arthursgonzaga/LineFollowerFPGA/Gerador PWM/sim93.PNG

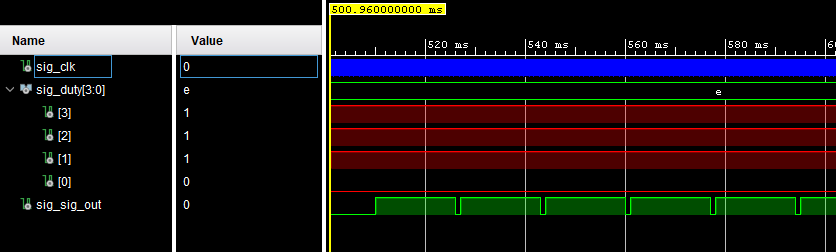
Gerador PWM/sim93.PNG
