arthursgonzaga/LineFollowerFPGA/Gerador PWM/sim_18.PNG

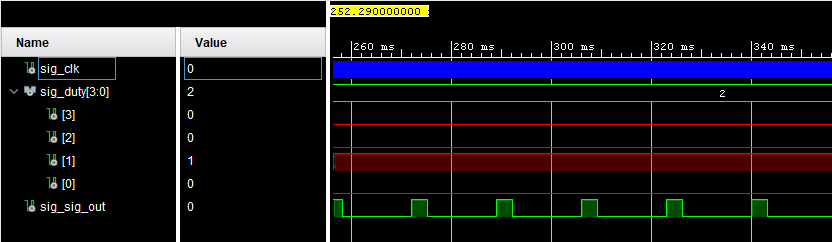
Gerador PWM/sim_18.PNG
