arthursgonzaga/LineFollowerFPGA/Gerador PWM/sim_50.PNG

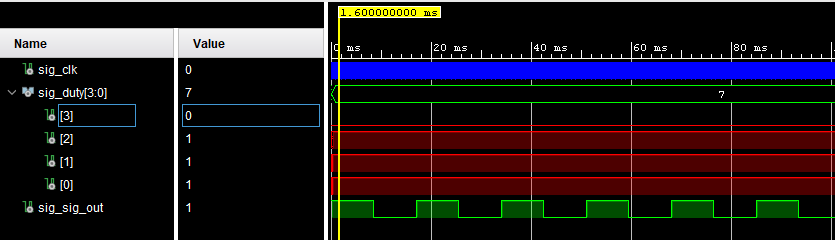
Gerador PWM/sim_50.PNG
