arthursgonzaga/LineFollowerFPGA/Maquina de Estados/trans_1.PNG

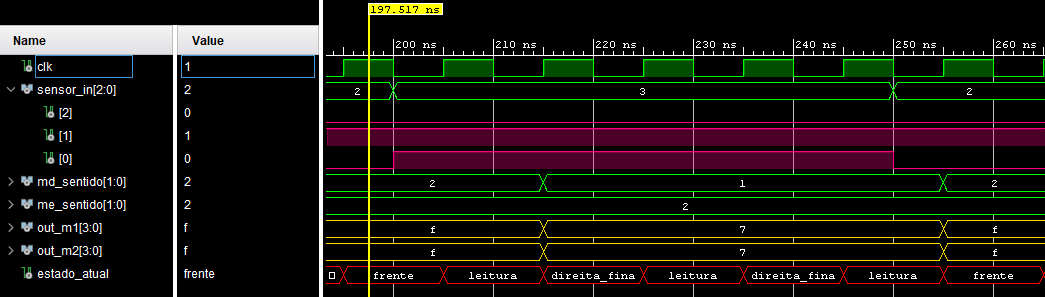
Maquina de Estados/trans_1.PNG
