arthursgonzaga/LineFollowerFPGA/(list of files, drawings)

Other design files:
Integracao/Simulacao_Potencia.pdsprj
