arthursgonzaga/LineFollowerFPGA/Integracao/design_1/ip/design_1_FSM_Controller_0_0/synth/design_1_FSM_Controller_0_0.vhd

-- (c) Copyright 1995-2018 Xilinx, Inc. All rights reserved.
-- 
-- This file contains confidential and proprietary information
-- of Xilinx, Inc. and is protected under U.S. and
-- international copyright and other intellectual property
-- laws.
-- 
-- DISCLAIMER
-- This disclaimer is not a license and does not grant any
-- rights to the materials distributed herewith. Except as
-- otherwise provided in a valid license issued to you by
-- Xilinx, and to the maximum extent permitted by applicable
-- law: (1) THESE MATERIALS ARE MADE AVAILABLE "AS IS" AND
-- WITH ALL FAULTS, AND XILINX HEREBY DISCLAIMS ALL WARRANTIES
-- AND CONDITIONS, EXPRESS, IMPLIED, OR STATUTORY, INCLUDING
-- BUT NOT LIMITED TO WARRANTIES OF MERCHANTABILITY, NON-
-- INFRINGEMENT, OR FITNESS FOR ANY PARTICULAR PURPOSE; and
-- (2) Xilinx shall not be liable (whether in contract or tort,
-- including negligence, or under any other theory of
-- liability) for any loss or damage of any kind or nature
-- related to, arising under or in connection with these
-- materials, including for any direct, or any indirect,
-- special, incidental, or consequential loss or damage
-- (including loss of data, profits, goodwill, or any type of
-- loss or damage suffered as a result of any action brought
-- by a third party) even if such damage or loss was
-- reasonably foreseeable or Xilinx had been advised of the
-- possibility of the same.
-- 
-- CRITICAL APPLICATIONS
-- Xilinx products are not designed or intended to be fail-
-- safe, or for use in any application requiring fail-safe
-- performance, such as life-support or safety devices or
-- systems, Class III medical devices, nuclear facilities,
-- applications related to the deployment of airbags, or any
-- other applications that could lead to death, personal
-- injury, or severe property or environmental damage
-- (individually and collectively, "Critical
-- Applications"). Customer assumes the sole risk and
-- liability of any use of Xilinx products in Critical
-- Applications, subject only to applicable laws and
-- regulations governing limitations on product liability.
-- 
-- THIS COPYRIGHT NOTICE AND DISCLAIMER MUST BE RETAINED AS
-- PART OF THIS FILE AT ALL TIMES.
-- 
-- DO NOT MODIFY THIS FILE.

-- IP VLNV: UnB_FGA:line_follower:FSM_Controller:3.0
-- IP Revision: 7

LIBRARY ieee;
USE ieee.std_logic_1164.ALL;
USE ieee.numeric_std.ALL;

ENTITY design_1_FSM_Controller_0_0 IS
  PORT (
    reset : IN STD_LOGIC;
    clk : IN STD_LOGIC;
    sensor_in : IN STD_LOGIC_VECTOR(2 DOWNTO 0);
    led : OUT STD_LOGIC_VECTOR(2 DOWNTO 0);
    md_sentido : OUT STD_LOGIC_VECTOR(1 DOWNTO 0);
    me_sentido : OUT STD_LOGIC_VECTOR(1 DOWNTO 0);
    md_out : OUT STD_LOGIC_VECTOR(3 DOWNTO 0);
    me_out : OUT STD_LOGIC_VECTOR(3 DOWNTO 0)
  );
END design_1_FSM_Controller_0_0;

ARCHITECTURE design_1_FSM_Controller_0_0_arch OF design_1_FSM_Controller_0_0 IS
  ATTRIBUTE DowngradeIPIdentifiedWarnings : STRING;
  ATTRIBUTE DowngradeIPIdentifiedWarnings OF design_1_FSM_Controller_0_0_arch: ARCHITECTURE IS "yes";
  COMPONENT FSM IS
    PORT (
      reset : IN STD_LOGIC;
      clk : IN STD_LOGIC;
      sensor_in : IN STD_LOGIC_VECTOR(2 DOWNTO 0);
      led : OUT STD_LOGIC_VECTOR(2 DOWNTO 0);
      md_sentido : OUT STD_LOGIC_VECTOR(1 DOWNTO 0);
      me_sentido : OUT STD_LOGIC_VECTOR(1 DOWNTO 0);
      md_out : OUT STD_LOGIC_VECTOR(3 DOWNTO 0);
      me_out : OUT STD_LOGIC_VECTOR(3 DOWNTO 0)
    );
  END COMPONENT FSM;
  ATTRIBUTE X_CORE_INFO : STRING;
  ATTRIBUTE X_CORE_INFO OF design_1_FSM_Controller_0_0_arch: ARCHITECTURE IS "FSM,Vivado 2018.1";
  ATTRIBUTE CHECK_LICENSE_TYPE : STRING;
  ATTRIBUTE CHECK_LICENSE_TYPE OF design_1_FSM_Controller_0_0_arch : ARCHITECTURE IS "design_1_FSM_Controller_0_0,FSM,{}";
  ATTRIBUTE X_INTERFACE_INFO : STRING;
  ATTRIBUTE X_INTERFACE_PARAMETER : STRING;
  ATTRIBUTE X_INTERFACE_PARAMETER OF clk: SIGNAL IS "XIL_INTERFACENAME clk, ASSOCIATED_RESET reset, FREQ_HZ 100000000, PHASE 0.0, CLK_DOMAIN /clk_wiz_clk_out1";
  ATTRIBUTE X_INTERFACE_INFO OF clk: SIGNAL IS "xilinx.com:signal:clock:1.0 clk CLK";
  ATTRIBUTE X_INTERFACE_PARAMETER OF reset: SIGNAL IS "XIL_INTERFACENAME reset, POLARITY ACTIVE_LOW";
  ATTRIBUTE X_INTERFACE_INFO OF reset: SIGNAL IS "xilinx.com:signal:reset:1.0 reset RST";
BEGIN
  U0 : FSM
    PORT MAP (
      reset => reset,
      clk => clk,
      sensor_in => sensor_in,
      led => led,
      md_sentido => md_sentido,
      me_sentido => me_sentido,
      md_out => md_out,
      me_out => me_out
    );
END design_1_FSM_Controller_0_0_arch;
